EricElectro/Circuits/Discrete_3V3_Linear_Regulator/LTSpice/3V3_Linear_Regulator_12mA_AltPNP.asc

C1: cap; {Cout}
ILoad: current; {iL} ; PULSE(12m 120m 10m 100n 100n 120u 3m) ;  Load current pulse;
Q2: pnp; FZT1151A
R1: res; 470
RBase: res; {base}
RF1: res; {FB1}
RF2: res; {FB2}
Rpull: res; {pull}
Rref: res; {ref}
RSense: res; {sense}
U1: opamp2; LM358
U2: TL431
V1: voltage; PULSE(0 50m 20m 10u 10u 5m 20m)
Vsupply: voltage; {Vs}
Named nets: Vs, 0, OpAmp_neg, OpAmp_pos, emitter, collector, base, OpAmp_out
; ---------- Include Libraries ----------
.inc TIP42C.lib
.inc LM358.lib
; ---------- Parameters ----------
.param Vs=5     ; Supply voltage
.param iL=12m  ; Load current
.param ref=1.6k ; Reference resistor
.param base=2.7k ; Base resistor
.param pull=10k ; Pull-up resistor
.param sense=0.22 ; Sense resistor
.param FB1=10k ; Feedback resistor 1
.param FB2=30.1k ; Feedback resistor 2
.param Cout=300uF ; Output capacitor
; ---------- Analysis ----------
;.op
.tran 0 200m 0 10u
;.ac dec 100 1 1e6
; --- Pulse Load Transient Analysis ---
; Replace {iL} parameter for ILoad with pulse definition
;PULSE(12m 120m 10m 100n 100n 120u 3m) ; Load current pulse
; ---------- Scaled Measurements ----------
;* Define unit prefixes
.param u=1e6 ; micro
.param m=1e3 ; milli
.param k=1e-3 ; kilo
 
;* steady-state measurements
.meas OP Vout PARAM V(collector)
.meas OP Vdropout PARAM V(emitter)-V(collector)
.meas OP Vref PARAM V(OpAmp_neg)
.meas OP I_Ref_mA PARAM Ix(U2:K)*m
.meas OP I_BJT_base_uA PARAM -Ib(Q1)*u
.meas OP I_BJT_emitter_mA PARAM Ie(Q1)*m
.meas OP I_BJT_collector_mA PARAM -Ic(Q1)*m
.meas OP Beta_BJT PARAM Ic(Q1)/Ib(Q1)
.model FZT1151A PNP IS=1.7e-12 NF=1.004 ISE=1.02e-13 NE=1.55 BF=250
+ VAF=26.01 IKF=3.5 NR=.97 ISC=1.5e-13 NC=1.3 BR=38
+ VAR=2.41 IKR=0.3 RE=25.37e-3 RB=250e-3 RC=25e-3
+ CJE=440e-12 CJC=160e-12 VJC=1.058 MJC=0.5678
+ TF=0.8e-9 TR=55.5e-9
