EricElectro/Circuits/(list of files, drawings)

Other design files:
Discrete_3V3_Linear_Regulator/Altium/Discrete_3V3_Linear_Regulator_Altium/Capacitors_NP_SMD_IPC.PcbLib
Discrete_3V3_Linear_Regulator/Altium/Discrete_3V3_Linear_Regulator_Altium/Capacitors_Tantalum_Polarized_SMD_IPC.PcbLib
Discrete_3V3_Linear_Regulator/Altium/Discrete_3V3_Linear_Regulator_Altium/Discrete_3V3_Linear_Regulator.PcbDoc
Discrete_3V3_Linear_Regulator/Altium/Discrete_3V3_Linear_Regulator_Altium/Discrete_3V3_Linear_Regulator.PrjPcb
Discrete_3V3_Linear_Regulator/Altium/Discrete_3V3_Linear_Regulator_Altium/Discrete_3V3_Linear_Regulator.SchDoc
Discrete_3V3_Linear_Regulator/Altium/Discrete_3V3_Linear_Regulator_Altium/FerriteBeads_SMD_IPC.PcbLib
Discrete_3V3_Linear_Regulator/Altium/Discrete_3V3_Linear_Regulator_Altium/Inductors_SMD_IPC.PcbLib
Discrete_3V3_Linear_Regulator/Altium/Discrete_3V3_Linear_Regulator_Altium/LDO_3V3.PcbLib
Discrete_3V3_Linear_Regulator/Altium/Discrete_3V3_Linear_Regulator_Altium/LDO_3V3.SchLib
Discrete_3V3_Linear_Regulator/Altium/Discrete_3V3_Linear_Regulator_Altium/Resistors_SMD_IPC.PcbLib
Discrete_3V3_Linear_Regulator/Altium/Discrete_3V3_Linear_Regulator_Altium/Standard_Passives.SchLib
