EricElectro/Circuits/Discrete_3V3_Linear_Regulator/image/README/ds1054z_capture_capture_Test3_Vout_VinMax.png

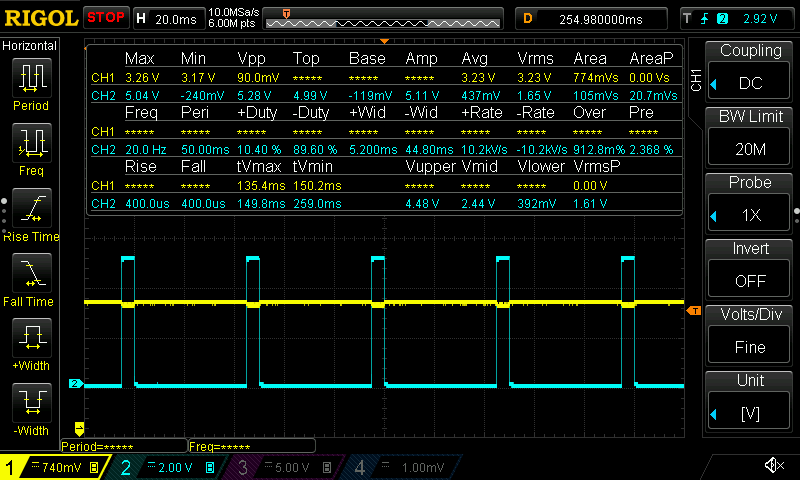
Discrete_3V3_Linear_Regulator/image/README/ds1054z_capture_capture_Test3_Vout_VinMax.png
