EricElectro/Circuits/(commit log)

2026-01-11 Pulse Load Test, Protoboard images, Altium Designer layout.
    [3V3_Linear_Regulator.fzz, 3V3_Linear_Regulator_Proto.fzz]
2026-01-15 Stop tracking Fritzing folder; add to .gitignore
    [3V3_Linear_Regulator.fzz, 3V3_Linear_Regulator_Proto.fzz]
2026-01-15 Stop tracking Fritzing files
    [Capacitors_NP_SMD_IPC.PcbLib, Capacitors_Tantalum_Polarized_SMD_IPC.PcbLib, Discrete_3V3_Linear_Regulator.PcbDoc, Discrete_3V3_Linear_Regulator.PrjPcb, Discrete_3V3_Linear_Regulator.SchDoc, FerriteBeads_SMD_IPC.PcbLib, Inductors_SMD_IPC.PcbLib, LDO_3V3.PcbLib]
